garrettsworkshop/MacIIROMSIMM/Documentation/MacIIROMSIMM.4402B-Schematic.pdf

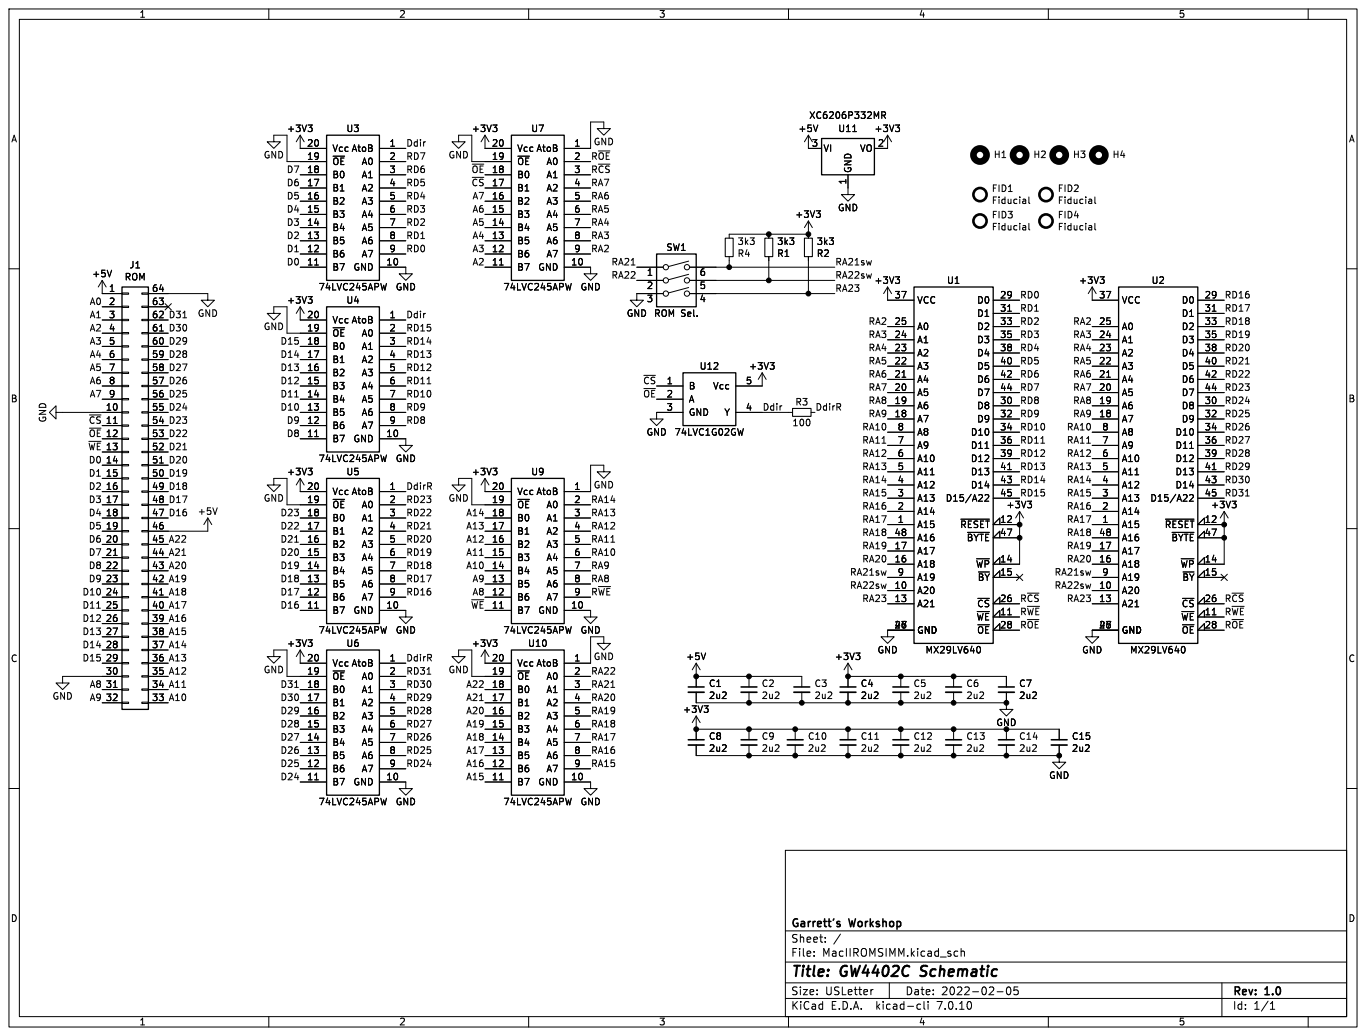
[picture p19: page 1]

1 VO 2 VI 3 U1 MX29LV640 GND 27 VCC 37 A15 1 A20 10 ~{WE}11 ~{RESET}12 A21 13 ~{WP}14 ~{BY}15 A18 16 A17 17 A7 18 A6 19 A14 2 A5 20 A4 21 A3 22 A2 23 A1 24 A0 25 ~{CS}26 ~{OE}28 D0 29 A13 3 D8 30 D1 31 D9 32 D2 33 D10 34 D3 35 D11 36 D4 38 D12 39 A12 4 D5 40 D13 41 D6 42 D14 43 D7 44 D15/A22 45 GND 46 ~{BYTE}47 A16 48 A11 5 A10 6 A9 7 A8 8 A19 9 GND
H1 FID1 Fiducial GND

File: MacIIROMSIMM.kicad_sch Sheet: / Garrett's Workshop C8
