garrettsworkshop/MacIIROMSIMM/Documentation/MacIIROMSIMM.4402B-Placement.pdf

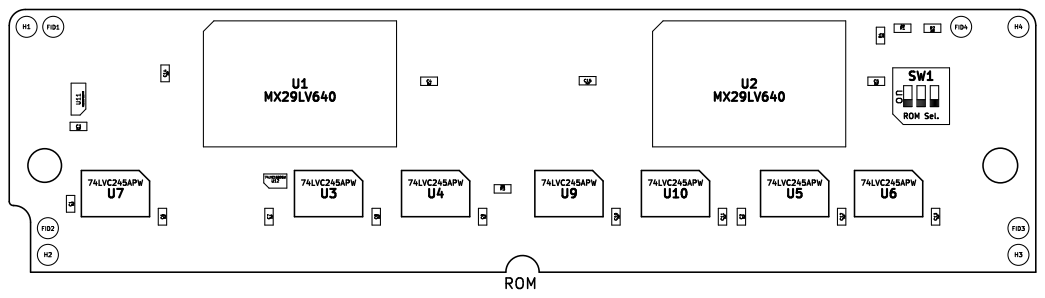
[picture p20: page 1]
