garrettsworkshop/MacIIROMSIMM/MacIIROMSIMM.kicad_pcb

## KiCad design MacIIROMSIMM.kicad_pcb (2024-05-19)

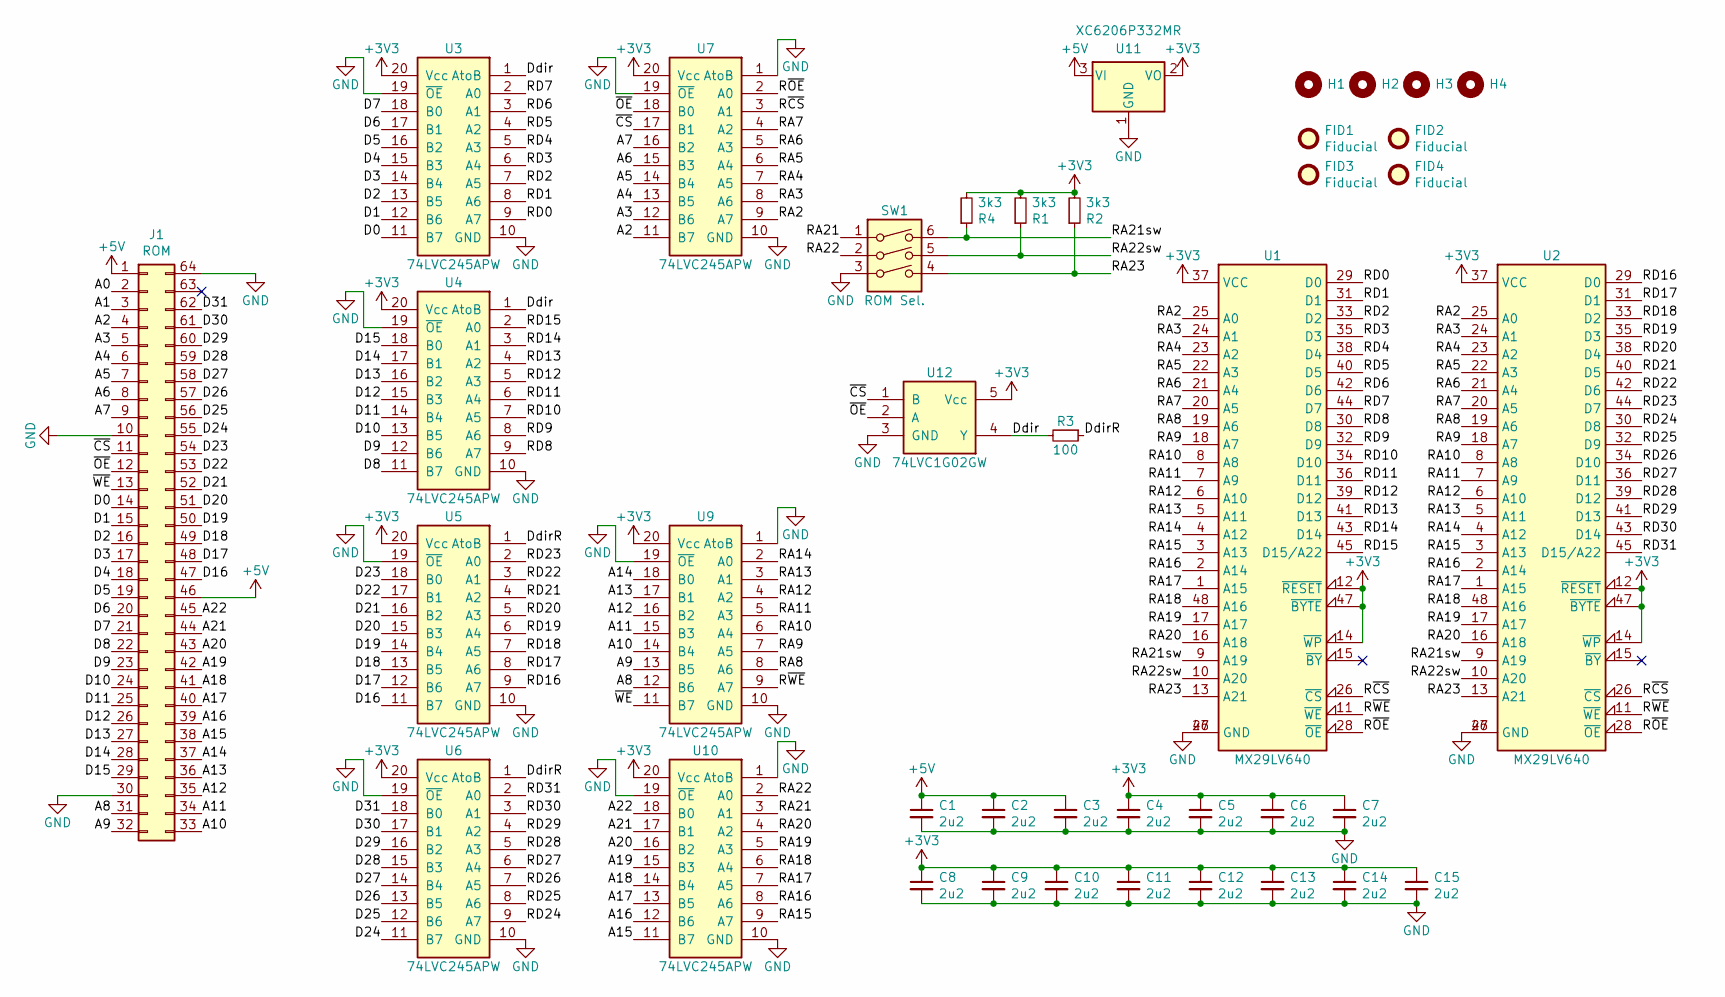
[picture p21: schematic MacIIROMSIMM.kicad_sch, GW4402C Schematic]

Parts:
C1, C2, C3, C4, C5, C6, C7, C8, C9, C10, C11, C12, C13, C14, C15: 2u2; C_0603; LCSC Part C23630
FID1, FID2, FID3, FID4: Fiducial
H1, H2, H3, H4: PasteHole_1.152mm_NPTH
J1: ROM; MacIIROMSIMM_Edge
R1, R2, R4: 3k3; R_0603; LCSC Part C22978
R3: 100; R_0603; LCSC Part C22775
SW1: ROM Sel.; SW_DIP_SPSTx03_Slide_DSHP03TS_P1.27mm; LCSC Part C319051
U1, U2: MX29LV640; TSOP-I-48_18.4x12mm_P0.5mm; LCSC Part C30076
U3, U4, U5, U6, U7, U9, U10: 74LVC245APW; TSSOP-20_4.4x6.5mm_P0.65mm; LCSC Part C6082
U11: XC6206P332MR; SOT-23; LCSC Part C5446
U12: 74LVC1G02GW; SOT-353; LCSC Part C353856

Connections:
+3V3: C4.1, C5.1, C6.1, C7.1, C8.1, C9.1, C10.1, C11.1, C12.1, C13.1, C14.1, C15.1, R1.2, R2.2, R4.2, U1.12 (~RESET), U1.14 (~WP), U1.37 (VCC), U1.47 (~BYTE), U2.12 (~RESET), U2.14 (~WP), U2.37 (VCC), U2.47 (~BYTE), U3.20 (Vcc), U4.20 (Vcc), U5.20 (Vcc), U6.20 (Vcc), U7.20 (Vcc), U9.20 (Vcc), U10.20 (Vcc), U11.2 (VO), U12.5 (Vcc)
+5V: C1.1, C2.1, C3.1, J1.1, J1.46, U11.3 (VI)
/A0: J1.2
/A1: J1.3
/A2: J1.4, U7.11 (B7)
/A3: J1.5, U7.12 (B6)
/A4: J1.6, U7.13 (B5)
/A5: J1.7, U7.14 (B4)
/A6: J1.8, U7.15 (B3)
/A7: J1.9, U7.16 (B2)
/A8: J1.31, U9.12 (B6)
/A9: J1.32, U9.13 (B5)
/A10: J1.33, U9.14 (B4)
/A11: J1.34, U9.15 (B3)
/A12: J1.35, U9.16 (B2)
/A13: J1.36, U9.17 (B1)
/A14: J1.37, U9.18 (B0)
/A15: J1.38, U10.11 (B7)
/A16: J1.39, U10.12 (B6)
/A17: J1.40, U10.13 (B5)
/A18: J1.41, U10.14 (B4)
/A19: J1.42, U10.15 (B3)
/A20: J1.43, U10.16 (B2)
/A21: J1.44, U10.17 (B1)
/A22: J1.45, U10.18 (B0)
/D0: J1.14, U3.11 (B7)
/D1: J1.15, U3.12 (B6)
/D2: J1.16, U3.13 (B5)
/D3: J1.17, U3.14 (B4)
/D4: J1.18, U3.15 (B3)
/D5: J1.19, U3.16 (B2)
/D6: J1.20, U3.17 (B1)
/D7: J1.21, U3.18 (B0)
/D8: J1.22, U4.11 (B7)
/D9: J1.23, U4.12 (B6)
/D10: J1.24, U4.13 (B5)
/D11: J1.25, U4.14 (B4)
/D12: J1.26, U4.15 (B3)
/D13: J1.27, U4.16 (B2)
/D14: J1.28, U4.17 (B1)
/D15: J1.29, U4.18 (B0)
/D16: J1.47, U5.11 (B7)
/D17: J1.48, U5.12 (B6)
/D18: J1.49, U5.13 (B5)
/D19: J1.50, U5.14 (B4)
/D20: J1.51, U5.15 (B3)
/D21: J1.52, U5.16 (B2)
/D22: J1.53, U5.17 (B1)
/D23: J1.54, U5.18 (B0)
/D24: J1.55, U6.11 (B7)
/D25: J1.56, U6.12 (B6)
/D26: J1.57, U6.13 (B5)
/D27: J1.58, U6.14 (B4)
/D28: J1.59, U6.15 (B3)
/D29: J1.60, U6.16 (B2)
/D30: J1.61, U6.17 (B1)
/D31: J1.62, U6.18 (B0)
/Ddir: R3.2, U3.1 (AtoB), U4.1 (AtoB), U12.4 (Y)
/DdirR: R3.1, U5.1 (AtoB), U6.1 (AtoB)
/RA2: U1.25 (A0), U2.25 (A0), U7.9 (A7)
/RA3: U1.24 (A1), U2.24 (A1), U7.8 (A6)
/RA4: U1.23 (A2), U2.23 (A2), U7.7 (A5)
/RA5: U1.22 (A3), U2.22 (A3), U7.6 (A4)
/RA6: U1.21 (A4), U2.21 (A4), U7.5 (A3)
/RA7: U1.20 (A5), U2.20 (A5), U7.4 (A2)
/RA8: U1.19 (A6), U2.19 (A6), U9.8 (A6)
/RA9: U1.18 (A7), U2.18 (A7), U9.7 (A5)
/RA10: U1.8 (A8), U2.8 (A8), U9.6 (A4)
/RA11: U1.7 (A9), U2.7 (A9), U9.5 (A3)
/RA12: U1.6 (A10), U2.6 (A10), U9.4 (A2)
/RA13: U1.5 (A11), U2.5 (A11), U9.3 (A1)
/RA14: U1.4 (A12), U2.4 (A12), U9.2 (A0)
/RA15: U1.3 (A13), U2.3 (A13), U10.9 (A7)
/RA16: U1.2 (A14), U2.2 (A14), U10.8 (A6)
/RA17: U1.1 (A15), U2.1 (A15), U10.7 (A5)
/RA18: U1.48 (A16), U2.48 (A16), U10.6 (A4)
/RA19: U1.17 (A17), U2.17 (A17), U10.5 (A3)
/RA20: U1.16 (A18), U2.16 (A18), U10.4 (A2)
/RA21: SW1.1, U10.3 (A1)
/RA21sw: R4.1, SW1.6, U1.9 (A19), U2.9 (A19)
/RA22: SW1.2, U10.2 (A0)
/RA22sw: R1.1, SW1.5, U1.10 (A20), U2.10 (A20)
/RA23: R2.1, SW1.4, U1.13 (A21), U2.13 (A21)
/RD0: U1.29 (D0), U3.9 (A7)
/RD1: U1.31 (D1), U3.8 (A6)
/RD2: U1.33 (D2), U3.7 (A5)
/RD3: U1.35 (D3), U3.6 (A4)
/RD4: U1.38 (D4), U3.5 (A3)
/RD5: U1.40 (D5), U3.4 (A2)
/RD6: U1.42 (D6), U3.3 (A1)
/RD7: U1.44 (D7), U3.2 (A0)
/RD8: U1.30 (D8), U4.9 (A7)
/RD9: U1.32 (D9), U4.8 (A6)
/RD10: U1.34 (D10), U4.7 (A5)
/RD11: U1.36 (D11), U4.6 (A4)
/RD12: U1.39 (D12), U4.5 (A3)
/RD13: U1.41 (D13), U4.4 (A2)
/RD14: U1.43 (D14), U4.3 (A1)
/RD15: U1.45 (D15/A22), U4.2 (A0)
/RD16: U2.29 (D0), U5.9 (A7)
/RD17: U2.31 (D1), U5.8 (A6)
/RD18: U2.33 (D2), U5.7 (A5)
/RD19: U2.35 (D3), U5.6 (A4)
/RD20: U2.38 (D4), U5.5 (A3)
/RD21: U2.40 (D5), U5.4 (A2)
/RD22: U2.42 (D6), U5.3 (A1)
/RD23: U2.44 (D7), U5.2 (A0)
/RD24: U2.30 (D8), U6.9 (A7)
/RD25: U2.32 (D9), U6.8 (A6)
/RD26: U2.34 (D10), U6.7 (A5)
/RD27: U2.36 (D11), U6.6 (A4)
/RD28: U2.39 (D12), U6.5 (A3)
/RD29: U2.41 (D13), U6.4 (A2)
/RD30: U2.43 (D14), U6.3 (A1)
/RD31: U2.45 (D15/A22), U6.2 (A0)
/R~CS: U1.26 (~CS), U2.26 (~CS), U7.3 (A1)
/R~OE: U1.28 (~OE), U2.28 (~OE), U7.2 (A0)
/R~WE: U1.11 (~WE), U2.11 (~WE), U9.9 (A7)
/~CS: J1.11, U7.17 (B1), U12.1 (B)
/~OE: J1.12, U7.18 (B0), U12.2 (A)
/~WE: J1.13, U9.11 (B7)
GND: C1.2, C2.2, C3.2, C4.2, C5.2, C6.2, C7.2, C8.2, C9.2, C10.2, C11.2, C12.2, C13.2, C14.2, C15.2, J1.10, J1.30, J1.64, SW1.3, U1.27 (GND), U1.46 (GND), U2.27 (GND), U2.46 (GND), U3.10 (GND), U3.19 (~OE), U4.10 (GND), U4.19 (~OE), U5.10 (GND), U5.19 (~OE), U6.10 (GND), U6.19 (~OE), U7.1 (AtoB), U7.10 (GND), U7.19 (~OE), U9.1 (AtoB), U9.10 (GND), U9.19 (~OE), U10.1 (AtoB), U10.10 (GND), U10.19 (~OE), U11.1 (GND), U12.3 (GND)

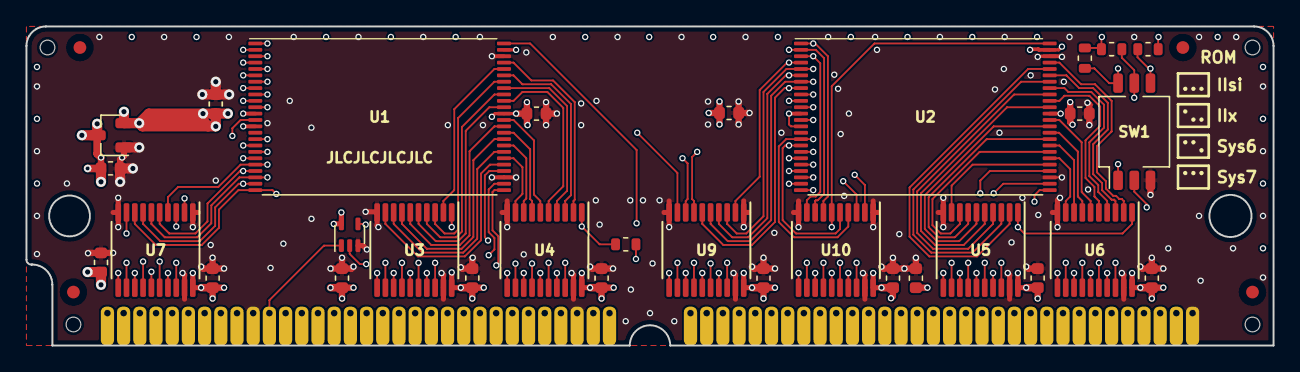
[picture p22: board MacIIROMSIMM.kicad_pcb from above]

Board: 4 copper layers, 97.8 x 25.0 mm, 40 parts (0 on the bottom side), 120 nets.
