garrettsworkshop/MacIIROMSIMM/(commit log)

2020-05-16 Better stitching, with refdes on back
    [ROMSIMM.kicad_pcb]
2020-05-16 Rounded corners
    [ROMSIMM.kicad_pcb]
2020-05-16 Moved 2MB simm to its own folder
    [ROMSIMM.kicad_pcb, ROMSIMM.sch]
2021-04-13 Move 4402B files into mail directory
    [ROMSIMM.kicad_pcb, ROMSIMM.sch]
2021-04-13 Move 4402A files into main directory
    [ROMSIMM.kicad_pcb, ROMSIMM.sch]
2021-04-13 Update footprint and symbol library paths
2021-06-21 Eliminated one 74AHC245PW
    [ROMSIMM.kicad_pcb, ROMSIMM.sch]
2021-07-01 Add mask cutout for edge connector pins on back
    [ROMSIMM.kicad_pcb]
2022-01-12 Start on triple DIP switch
    [ROMSIMM.kicad_pcb]
2022-02-06 Migrate to KiCAD 6
    [ROMSIMM.kicad_pcb, ROMSIMM.sch]
2023-01-17 Add new GW logotype
    [ROMSIMM.kicad_pcb]
2024-02-16 Change project file name to MacIIROMSIMM
    [MacIIROMSIMM.kicad_pcb, MacIIROMSIMM.kicad_sch]
2024-05-06 idk build?
    [MacIIROMSIMM-B_Cu.gbl, MacIIROMSIMM-B_Mask.gbs, MacIIROMSIMM-B_Silkscreen.gbo, MacIIROMSIMM-Edge_Cuts.gm1, MacIIROMSIMM-F_Cu.gtl, MacIIROMSIMM-F_Mask.gts, MacIIROMSIMM-F_Paste.gtp, MacIIROMSIMM-F_Silkscreen.gto]
2024-05-19 Build and changed text to 4402B
    [MacIIROMSIMM-B_Cu.gbl, MacIIROMSIMM-B_Mask.gbs, MacIIROMSIMM-B_Silkscreen.gbo, MacIIROMSIMM-Edge_Cuts.gm1, MacIIROMSIMM-F_Cu.gtl, MacIIROMSIMM-F_Mask.gts, MacIIROMSIMM-F_Paste.gtp, MacIIROMSIMM-F_Silkscreen.gto]
2024-05-19 Update makefile to add BOM generation
